LittleIceCake/FM-Radio-Receiver-AI8051U/hardware/2D_PCB1_2.png

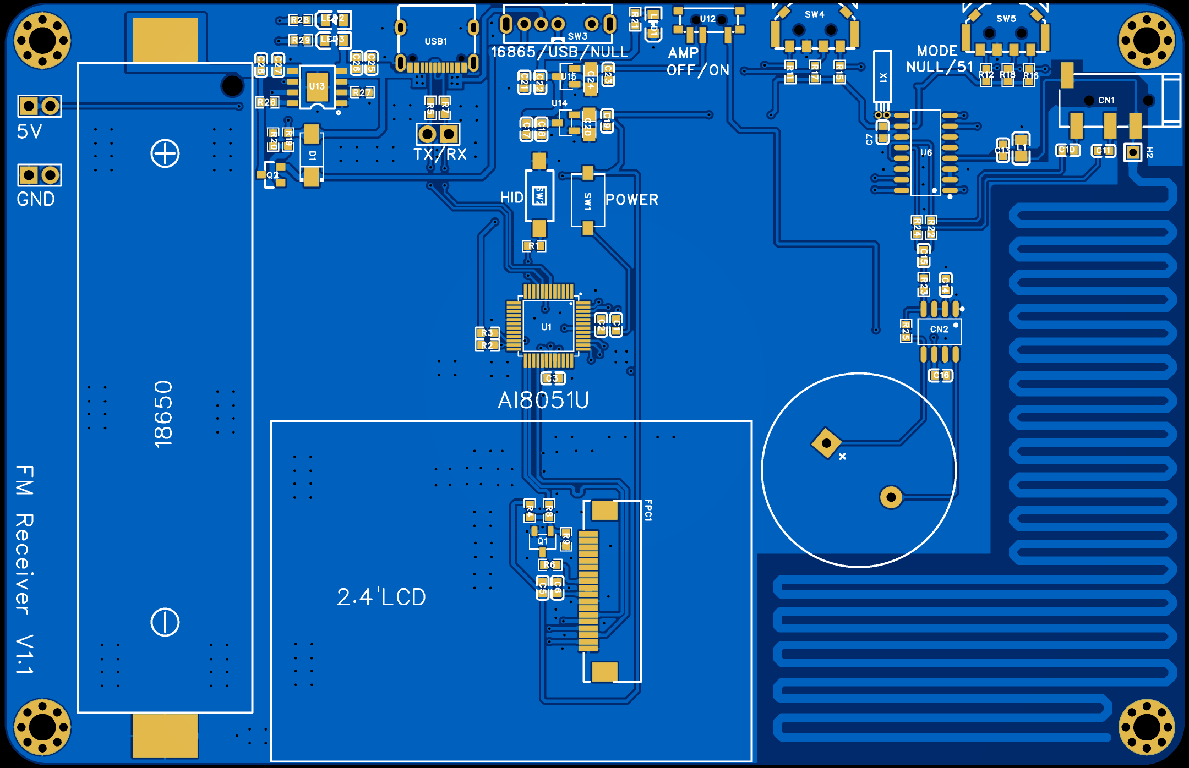
hardware/2D_PCB1_2.png
