LittleIceCake/FM-Radio-Receiver-AI8051U/hardware/3D_PCB1_2.png

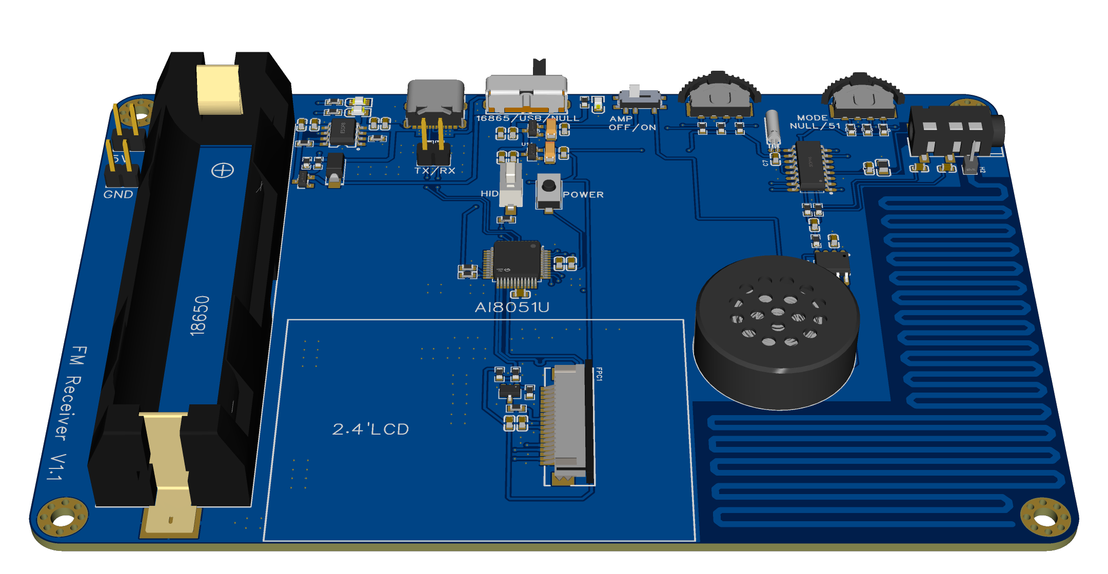
hardware/3D_PCB1_2.png
