LittleIceCake/FM-Radio-Receiver-AI8051U/ui/UI.png

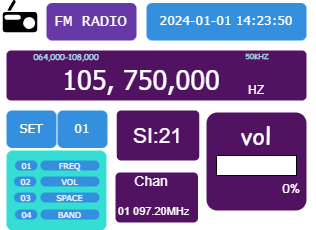
ui/UI.png
