LittleIceCake/FM-Radio-Receiver-AI8051U/hardware/BOM_v1.1_PCB1_2.xlsx

No. | Quantity | Designator | Footprint | Value | Category | Comment | Name | Device
1 | 1 | BT1 | BATTERY-SMD_18650-1S-L77.1-W20.7-1 |  | 连接器:纽扣与条形电池连接器 | BH-18650-B1BA002 | BH-18650-B1BA002 | BH-18650-B1BA002
2 | 1 | C1 | C0603 | 22uF | 电容:贴片电容(MLCC) | 22uF | 22uF | CL10A226MQ8NRNC
3 | 10 | C2,C3,C6,C7,C18,C19,C22,C23,C26,C27 | C0603 | 100nF | 电容:贴片电容(MLCC) | 100nF | 100nF | CC0603KRX7R9BB104
4 | 1 | C5 | C0603 | 4.7uF | 电容:贴片电容(MLCC) | 4.7uF | 4.7uF | CL10A475KO8NNNC
5 | 4 | C10,C11,C14,C16 | C0603 | 1uF | 电容:贴片电容(MLCC) | 1uF | 1uF | MCASE168SB7105KTNA01
6 | 1 | C13 | C0603 | 22pF | 电容:贴片电容(MLCC) | 22pF | 22pF | CL10C220JB8NNNC
7 | 1 | C15 | C0603 | 220nF | 电容:贴片电容(MLCC) | 220nF | 220nF | CL10B224KA8NNNC
8 | 4 | C17,C21,C25,C28 | C0603 | 10uF | 电容:贴片电容(MLCC) | 10uF | 10uF | CL10A106KP8NNNC
9 | 2 | C20,C24 | CASE-A_3216 | 22uF | 电容:钽电容 | 22uF | 22uF | TAJA226K010RNJ
10 | 1 | CN1 | AUDIO-SMD_PJ-320D |  | 连接器:音频连接器(耳机) | PJ-320D | PJ-320D | PJ-320D_C431535
11 | 1 | CN2 | SOP-8_L5.0-W3.8-P1.27-LS6.0-BL |  | 运算放大器/比较器:音频功率放大器 | AD8002D | AD8002D | AD8002D
12 | 1 | D1 | SMA_L4.2-W2.6-LS5.3-RD |  | 二极管:肖特基二极管 | SS14 | SS14 | SS14_C2480
13 | 1 | FPC1 | FPC-SMD_P0.80-18P_WSXJ |  | 连接器:FFC/FPC连接器 | AFC08-S18FCA-00 | AFC08-S18FCA-00 | AFC08-S18FCA-00
14 | 1 | H2 | HDR-TH_1P-V-M_XKB_X4611WV-01I-C28D40 |  | 连接器:排针 | HDR-M_2.54_1x1P |  | HDR-M_2.54_1x1P
15 | 4 | HOLE1,HOLE2,HOLE3,HOLE4 | m3 125x300 |  | 螺丝孔:M3 | M3 | M3 | m3_梅花螺丝孔
16 | 1 | L1 | L0805 | 100uH | 电感/线圈/变压器:贴片电感 | 100uH | 100uH | MLZ2012N101LT000
17 | 2 | LED1,LED3 | LED0805-RD |  | 光电器件:发光二极管/LED | NCD0805C1 | NCD0805C1 | NCD0805C1
18 | 1 | LED2 | LED0805-R-RD |  | 光电器件:发光二极管/LED | NCD0805R1 | NCD0805R1 | NCD0805R1
19 | 1 | Q1 | SOT-23-3_L2.9-W1.6-P1.90-LS2.8-BR |  | 三极管/MOS管/晶体管:三极管(BJT) | S8050 | S8050 | S8050_C181158
20 | 1 | Q2 | SOT-23_L2.9-W1.3-P1.90-LS2.4-BR |  | 三极管/MOS管/晶体管:场效应管(MOSFET) | AO3401A | AO3401A | AO3401A_C15127
21 | 1 | R1 | R0603 | 300Ω | 电阻:贴片电阻 | 300Ω | 300Ω | 0603WAF3000T5E
22 | 11 | R2,R3,R4,R6,R9,R11,R12,R15,R16,R17,R18 | R0603 | 10kΩ | 电阻:贴片电阻 | 10kΩ | 10kΩ | 0603WAF1002T5E
23 | 2 | R5,R7 | R0603 | 22Ω | 电阻:贴片电阻 | 22Ω | 22Ω | 0603WAF220JT5E
24 | 5 | R8,R19,R26,R28,R29 | R0603 | 1kΩ | 电阻:贴片电阻 | 1kΩ | 1kΩ | 0603WAF1001T5E
25 | 2 | R20,R27 | R0603 | 2kΩ | 电阻:贴片电阻 | 2kΩ | 2kΩ | 0603WAF2001T5E
26 | 4 | R21,R22,R23,R24 | R0603 | 22kΩ | 电阻:贴片电阻 | 22kΩ | 22kΩ | 0603WAF2202T5E
27 | 1 | R25 | R0603 | 68kΩ | 电阻:贴片电阻 | 68kΩ | 68kΩ | 0603WAF6802T5E
28 | 1 | SPK1 | SPK-TH_BD23.0-P10.00-D0.8-L-RD |  | 音频器件/振动马达:扬声器/喇叭 | GSPK2307P-8R1W | GSPK2307P-8R1W | GSPK2307P-8R1W
29 | 1 | SW1 | KEY-SMD_2P-L6.0-W3.8-LS7.30-L |  | 按键/开关:轻触开关 | TS-1089A-B3D4 | TS-1089A-B3D4 | TS-1089A-B3D4
30 | 1 | SW2 | SW-SMD_L6.0-W3.3-LS8.0 |  | 按键/开关:轻触开关 | TS-1101-C-W | TS-1101-C-W | TS-1101-C-W
31 | 1 | SW3 | SW-TH_SK13D07VG5 |  | 按键/开关:滑动开关 | SK13D07VG5 | SK13D07VG5 | SK13D07VG5
32 | 2 | SW4,SW5 | SW-SMD_TM-2024A |  | 按键/开关:拨轮开关 | TM-2024A | TM-2024A | TM-2024A
33 | 1 | U1 | LQFP-48_L7.0-W7.0-P0.50-LS9.0-BL_1 |  | 单片机/微控制器:单片机(MCU/MPU/SOC) | AI8051U-34K64-QFP48 | AI8051U-34K64-QFP48 | AI8051U-34K64-QFP48
34 | 3 | U2,U3,U4 | HDR-TH_2P-P2.54-V-M |  | 连接器:排针 | ZX-PZ2.54-1-2PZZ | ZX-PZ2.54-1-2PZZ | ZX-PZ2.54-1-2PZZ
35 | 1 | U6 | SOP-16_L10.0-W3.9-P1.27-LS6.0-BL |  | 射频芯片/天线:无线收发芯片 | RDA5807FP | RDA5807FP | RDA5807FP
36 | 1 | U12 | SW-SMD_MSS12C02LS-HB2.0-1 |  | 按键/开关:滑动开关 | MSS12C02LS-BB2.0 | MSS12C02LS-BB2.0 | MSS12C02LS-BB2.0
37 | 1 | U13 | ESOP-8_L4.9-W3.9-P1.27-LS6.0-BL-EP |  | 电源管理:电池管理 | TP4056 | TP4056 | TP4056_C725790
38 | 2 | U14,U15 | SOT-23-3_L2.9-W1.3-P1.90-LS2.4-BR |  | 电源管理:线性稳压器(LDO) | XC6206P332MR | XC6206P332MR | XC6206P332MR_C5148692
39 | 1 | USB1 | USB-C-SMD_TYPE-C-6PIN-2MD-073 |  | 连接器:USB连接器 | TYPE-C 16PIN 2MD(073) | TYPE-C 16PIN 2MD(073) | TYPE-C 16PIN 2MD(073)
40 | 1 | X1 | OSC-TH_BD2.0-P0.70-D0.3 | 32.768kHz | 振荡器/谐振器:无源晶振 | 32.768kHz | 32.768kHz | TAXD32768K2BGDAZT2T
