LittleIceCake/FM-Radio-Receiver-AI8051U/hardware/SCH_Schematic1_2.pdf

# 烧录按键

# TYPE-C接口

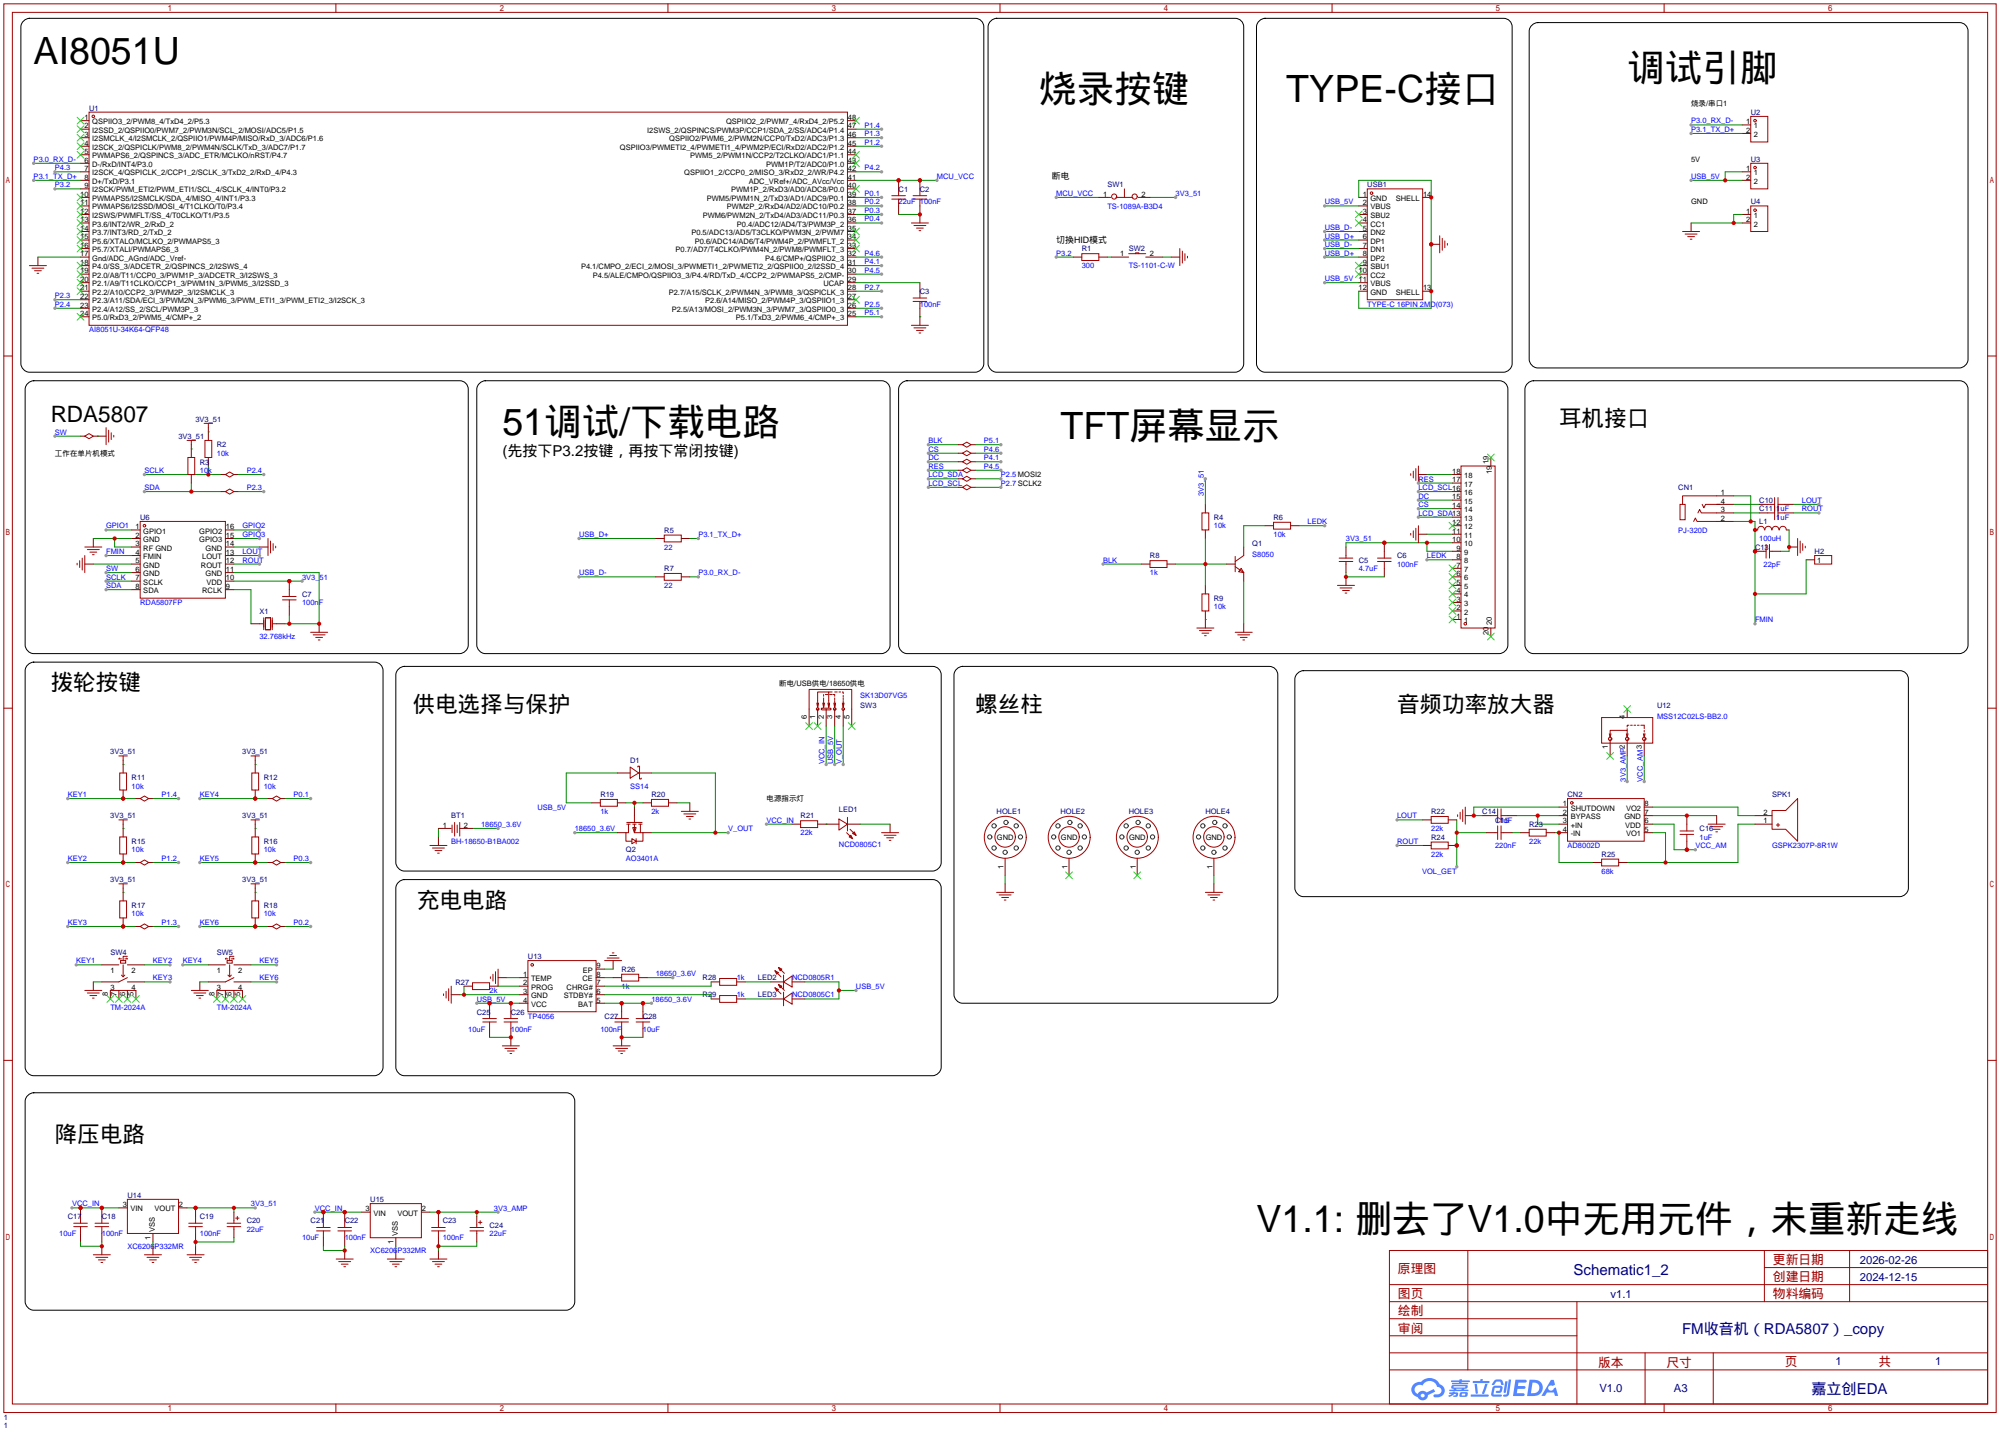
[picture p5: page 1]

VDD 10 GND 11 ROUT 12 LOUT 13 GND 14 GPIO3 15 GPIO2 16
