LittleIceCake/FM-Radio-Receiver-AI8051U/firmware/Delay.c

/*---------------------------------------------------------------------*/
/* --- STC MCU Limited ------------------------------------------------*/
/* --- STC 1T Series MCU Demo Programme -------------------------------*/
/* --- Mobile: (86)13922805190 ----------------------------------------*/
/* --- Fax: 86-0513-55012956,55012947,55012969 ------------------------*/
/* --- Tel: 86-0513-55012928,55012929,55012966 ------------------------*/
/* --- Web: www.STCAI.com ---------------------------------------------*/
/* --- BBS: www.STCAIMCU.com  -----------------------------------------*/
/* --- QQ:  800003751 -------------------------------------------------*/
/* 如果要在程序中使用此代码,请在程序中注明使用了STC的资料及程序            */
/*---------------------------------------------------------------------*/

#include	"Delay.h"

//========================================================================
// 函数: void delay_ms(unsigned char ms)
// 描述: 延时函数。
// 参数: ms,要延时的ms数, 这里只支持1~255ms. 自动适应主时钟.
// 返回: none.
// 版本: VER1.0
// 日期: 2021-3-9
// 备注: 
//========================================================================
void delay_ms(unsigned char ms)
{
	unsigned int i;
	do{
		i = MAIN_Fosc / 10000;
		while(--i);
	}while(--ms);
}

void  delay_s(unsigned char s){
	
	do{
		delay_ms(250);
		delay_ms(250);
		delay_ms(250);
		delay_ms(250);
	}while(s--);
}
