LittleIceCake/FM-Radio-Receiver-AI8051U/firmware/lcd_init.h

#ifndef __LCD_INIT_H
#define __LCD_INIT_H

#include "Config.h"

#define USE_HORIZONTAL 2  //设置横屏或者竖屏显示 0或1为竖屏 2或3为横屏
#define Chip_Selection 1   //设置芯片初始化 0为ILI9341  1为ST7789

#if USE_HORIZONTAL==0||USE_HORIZONTAL==1
#define LCD_W 240
#define LCD_H 320

#else
#define LCD_W 320
#define LCD_H 240
#endif

#define u8  unsigned char
#define u16 unsigned int

sbit LCD_SCL=P2^7;//SCLK
sbit LCD_SDA=P2^5;//MOSI
sbit LCD_RES=P4^5;//RES
sbit LCD_DC =P4^1;//DC
sbit LCD_CS =P4^6; //CS
sbit LCD_BLK=P5^1; //BLK

//-----------------LCD端口定义----------------

#define LCD_SCLK_Clr() LCD_SCL=0//SCL=SCLK
#define LCD_SCLK_Set() LCD_SCL=1

#define LCD_MOSI_Clr() LCD_SDA=0//SDA=MOSI
#define LCD_MOSI_Set() LCD_SDA=1

#define LCD_RES_Clr() LCD_RES=0//RES
#define LCD_RES_Set() LCD_RES=1

#define LCD_DC_Clr() LCD_DC=0//DC
#define LCD_DC_Set() LCD_DC=1

#define LCD_CS_Clr()  LCD_CS=0//CS
#define LCD_CS_Set()  LCD_CS=1

#define LCD_BLK_Clr()  LCD_BLK=0//BLK
#define LCD_BLK_Set()  LCD_BLK=1




void LCD_GPIO_Init(void);//初始化GPIO
void LCD_Writ_Bus(u8 dat);//模拟SPI时序
void LCD_WR_DATA8(u8 dat);//写入一个字节
void LCD_WR_DATA(u16 dat);//写入两个字节
void LCD_WR_REG(u8 dat);//写入一个指令
void LCD_Address_Set(u16 x1,u16 y1,u16 x2,u16 y2);//设置坐标函数
void LCD_Init(void);//LCD初始化
#endif
