LittleIceCake/FM-Radio-Receiver-AI8051U/(commit log)

2026-02-28 Initial commit: FM Radio Receiver project
    [BOM_v1.1_PCB1_2.xlsx]
2026-03-03 add doc/UART_Command.md and updata README.md
2026-03-22 Add datasheet documentation
    [RDA5807_reg.xlsx]
